UCSD-Quadcopter-Class/quad-hardware-douloureux/quadcopter.brd

## EAGLE design quadcopter.brd (2017-05-18)

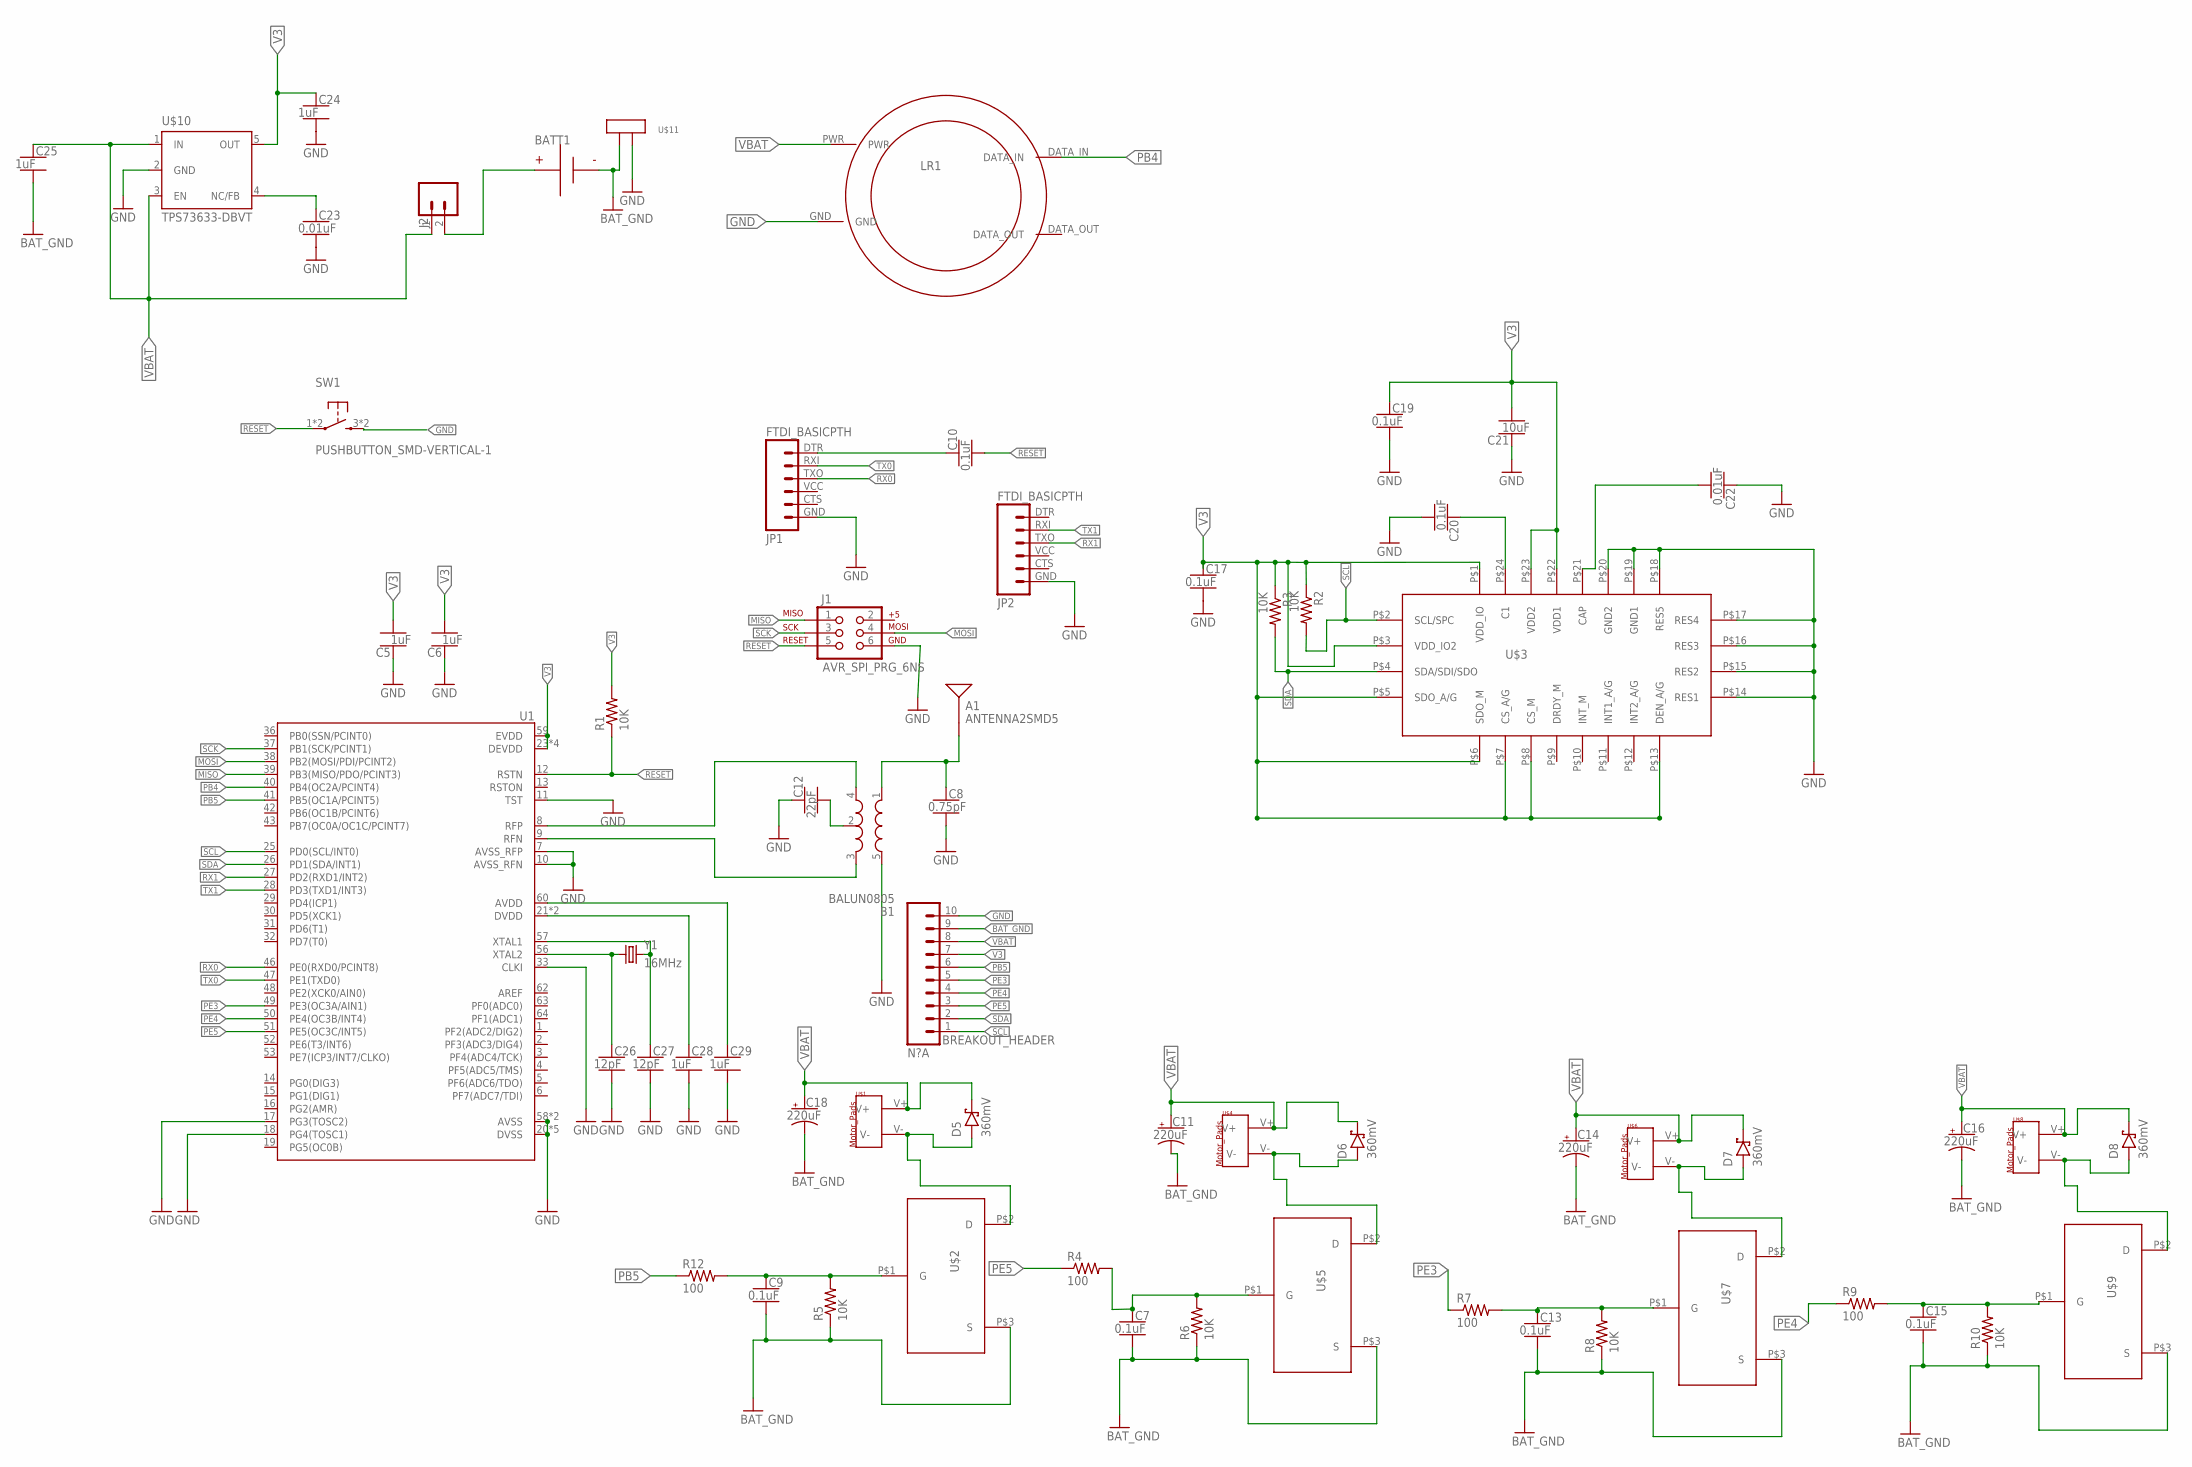
[picture p1: schematic quadcopter.sch]

Parts:
A1: ANTENNA2SMD5; ANTENNA-CHIP5
B1: BALUN0805; BALUN
BATT1: BATTERY-HUBSAN-W/HOLDER; BATTERY-W/HOLDER-380MAH-HUBSAN
BREAKOUT_HEADER: N?A; HDRV10W63P254_10X1_2540X254H838_HS
C5, C6, C24, C25, C28, C29: 1uF; CAPC2012X140_HS
C7, C9, C13, C15: 0.1uF; CERAMIC_CAP_0805
C8: 0.75pF; CAPC2012X140_HS
C10, C17, C19, C20: 0.1uF; CAPC2012X140_HS
C11, C14, C16, C18: 220uF; CAPMP7343X310_HS
C12: 22pF; CAPC2012X140_HS
C21: 10uF; CAPC2012X140_HS
C22, C23: 0.01uF; CAPC2012X140_HS
C26, C27: 12pF; CAPC2012X140_HS
D5, D6, D7, D8: 360mV; SOD3716X135_HS
J1: AVR_SPI_PRG_6NS; 2X3-NS
J2: MALE_HEADER_2POS-2X1-0.1IN; MALE_HEADER_2X1_0.1IN
JP1, JP2: FTDI_BASICPTH; FTDI_BASIC
LR1: LED_RING
R1, R2, R3, R5, R6, R8, R10: 10K; RESC2012X60_HS
R4, R7, R9, R12: 100; RESC2012X60_HS
SW1: PUSHBUTTON_SMD-VERTICAL-1; TE_FSM8JSMA_HS
U1: ATMEGA128RFA1; QFN-64
U$1, U$4, U$6, U$8: MOTOR_PADS
U$2, U$5, U$7, U$9: N-CHANNEL_MOSFET; N-CHANNELMOFSET
U$3: 9-AXIS_IMU
U$10: TPS73633-DBVT; SOT23-DBV
U$11: NET_BRIDGE
Y1: 16MHz; CRYSTAL-SMD-5X3

Connections:
BAT_GND: BATT1.- (N), BREAKOUT_HEADER.9, C7.2, C9.2, C11.2 (-), C13.2, C14.2 (-), C15.2, C16.2 (-), C18.2 (-), C25.2, R5.1, R6.1, R8.1, R10.1, U$2.P$3 (S), U$5.P$3 (S), U$7.P$3 (S), U$9.P$3 (S), U$11.P$1
GND: B1.5 (GND), BREAKOUT_HEADER.10, C5.1, C6.1, C8.2, C12.1, C17.2, C19.2, C20.2, C21.1, C22.1, C23.2, C24.2, C26.2, C27.2, C28.2, C29.2, J1.6, JP1.GND (6), JP2.GND (6), LR1.GND, SW1.3 (2), SW1.4 (2), U1.7 (AVSS_RFP), U1.10 (AVSS_RFN), U1.11 (TST), U1.17 (PG3(TOSC2)), U1.18 (PG4(TOSC1)), U1.20 (DVSS), U1.24 (DVSS), U1.33 (CLKI), U1.35 (DVSS), U1.45 (DVSS), U1.55 (DVSS), U1.58 (AVSS), U1.61 (AVSS), U$3.P$14 (RES1), U$3.P$15 (RES2), U$3.P$16 (RES3), U$3.P$17 (RES4), U$3.P$18 (RES5), U$3.P$19 (GND1), U$3.P$20 (GND2), U$10.2 (GND), U$11.P$2
MISO: J1.1, U1.39 (PB3(MISO/PDO/PCINT3))
MOSI: J1.4, U1.38 (PB2(MOSI/PDI/PCINT2))
unnamed: C9.1, R5.2, R12.2, U$2.P$1 (G)
unnamed: C7.1, R4.2, R6.2, U$5.P$1 (G)
unnamed: A1.FEED, B1.1 (IN), C8.1
unnamed: B1.2 (GND), C12.2
unnamed: C10.1, JP1.DTR (1)
unnamed: D6.A, U$4.V-, U$5.P$2 (D)
unnamed: C13.1, R7.2, R8.2, U$7.P$1 (G)
unnamed: D5.A, U$1.V-, U$2.P$2 (D)
unnamed: D7.A, U$6.V-, U$7.P$2 (D)
unnamed: C15.1, R9.2, R10.2, U$9.P$1 (G)
unnamed: D8.A, U$8.V-, U$9.P$2 (D)
unnamed: C20.1, U$3.P$24 (C1)
unnamed: C22.2, U$3.P$21 (CAP)
unnamed: C26.1, U1.56 (XTAL2), Y1.1
unnamed: BATT1.+, J2.2
unnamed: C23.1, U$10.4 (NC/FB)
unnamed: B1.4 (OUT1), U1.8 (RFP)
unnamed: B1.3 (OUT2), U1.9 (RFN)
unnamed: C29.1, U1.60 (AVDD)
unnamed: C28.1, U1.21 (DVDD), U1.22 (DVDD)
unnamed: C27.1, U1.57 (XTAL1), Y1.3 (2)
PB4: LR1.DATA_IN, U1.40 (PB4(OC2A/PCINT4))
PB5: BREAKOUT_HEADER.6, R12.1, U1.41 (PB5(OC1A/PCINT5))
PE3: BREAKOUT_HEADER.5, R7.1, U1.49 (PE3(OC3A/AIN1))
PE4: BREAKOUT_HEADER.4, R9.1, U1.50 (PE4(OC3B/INT4))
PE5: BREAKOUT_HEADER.3, R4.1, U1.51 (PE5(OC3C/INT5))
RESET: C10.2, J1.5, R1.1, SW1.1, SW1.2 (1), U1.12 (RSTN)
RX0: JP1.TXO (3), U1.46 (PE0(RXD0/PCINT8))
RX1: JP2.TXO (3), U1.27 (PD2(RXD1/INT2))
SCK: J1.3, U1.37 (PB1(SCK/PCINT1))
SCL: BREAKOUT_HEADER.1, R2.2, U1.25 (PD0(SCL/INT0)), U$3.P$2 (SCL/SPC)
SDA: BREAKOUT_HEADER.2, R3.2, U1.26 (PD1(SDA/INT1)), U$3.P$4 (SDA/SDI/SDO)
TX0: JP1.RXI (2), U1.47 (PE1(TXD0))
TX1: JP2.RXI (2), U1.28 (PD3(TXD1/INT3))
V3: BREAKOUT_HEADER.7, C5.2, C6.2, C17.1, C19.1, C21.2, C24.1, R1.2, R2.1, R3.1, U1.23 (DEVDD), U1.34 (DEVDD), U1.44 (DEVDD), U1.54 (DEVDD), U1.59 (EVDD), U$3.P$1 (VDD_IO), U$3.P$3 (VDD_IO2), U$3.P$5 (SDO_A/G), U$3.P$6 (SDO_M), U$3.P$7 (CS_A/G), U$3.P$8 (CS_M), U$3.P$13 (DEN_A/G), U$3.P$22 (VDD1), U$3.P$23 (VDD2), U$10.5 (OUT)
VBAT: BREAKOUT_HEADER.8, C11.1 (+), C14.1 (+), C16.1 (+), C18.1 (+), C25.1, D5.C, D6.C, D7.C, D8.C, J2.1, LR1.PWR, U$1.V+, U$4.V+, U$6.V+, U$8.V+, U$10.1 (IN), U$10.3 (EN)

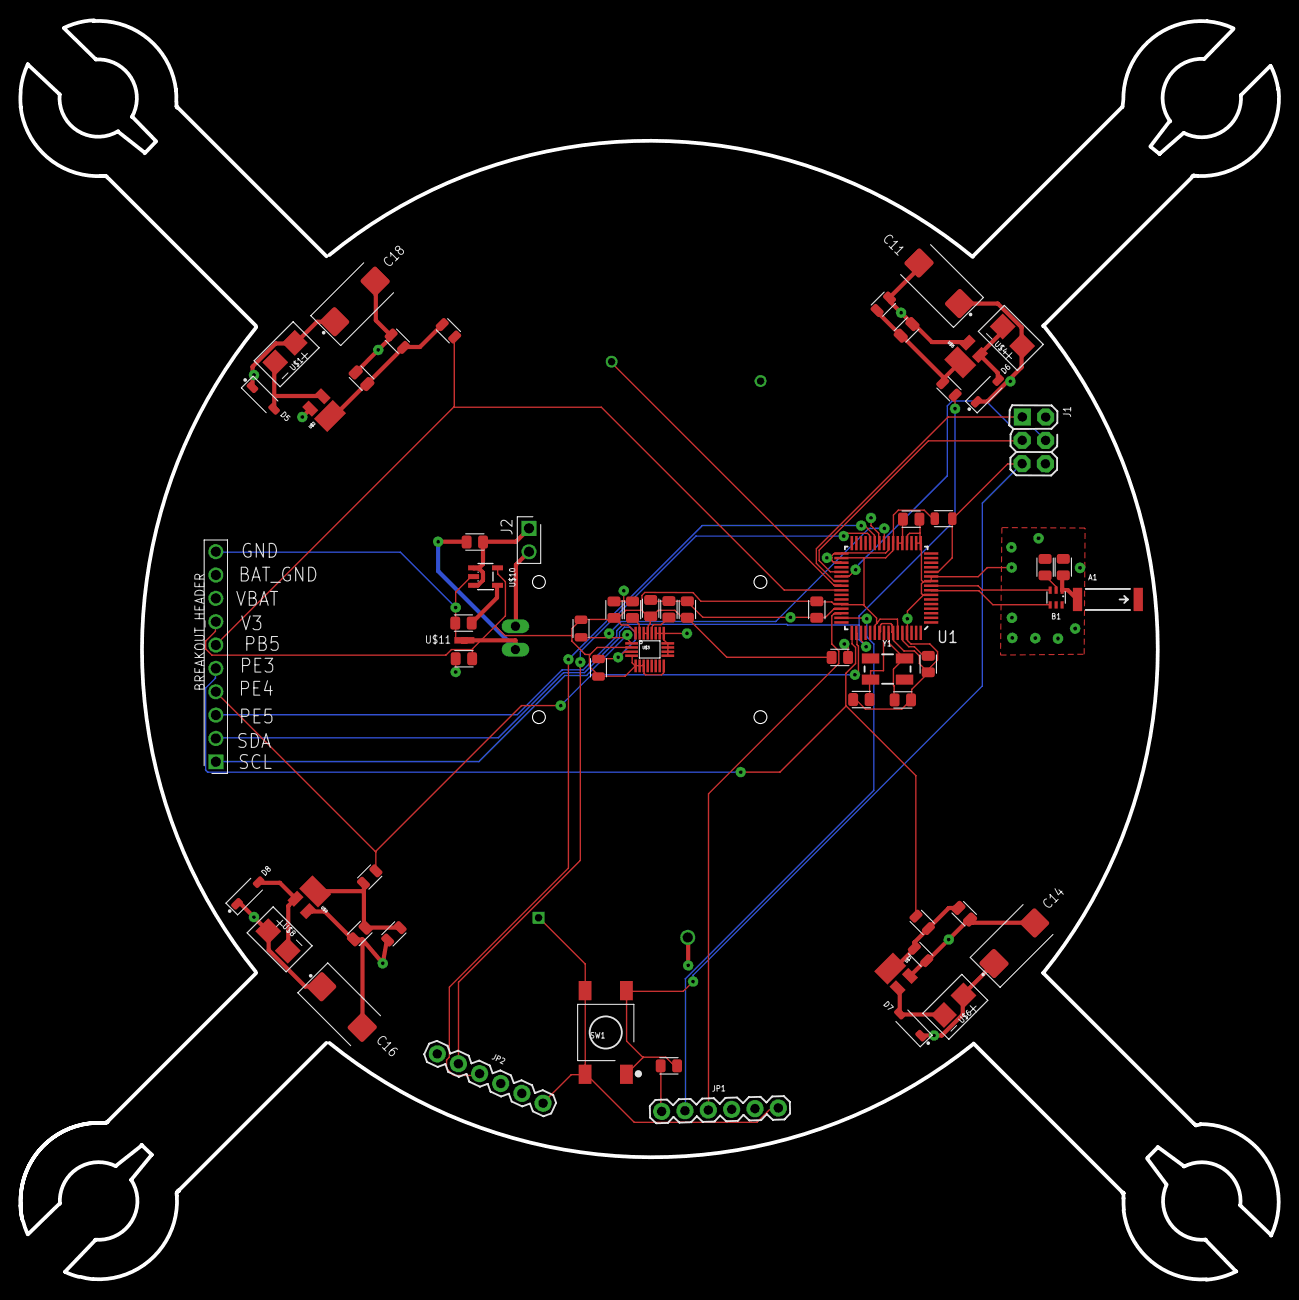
[picture p2: board quadcopter.brd from above]

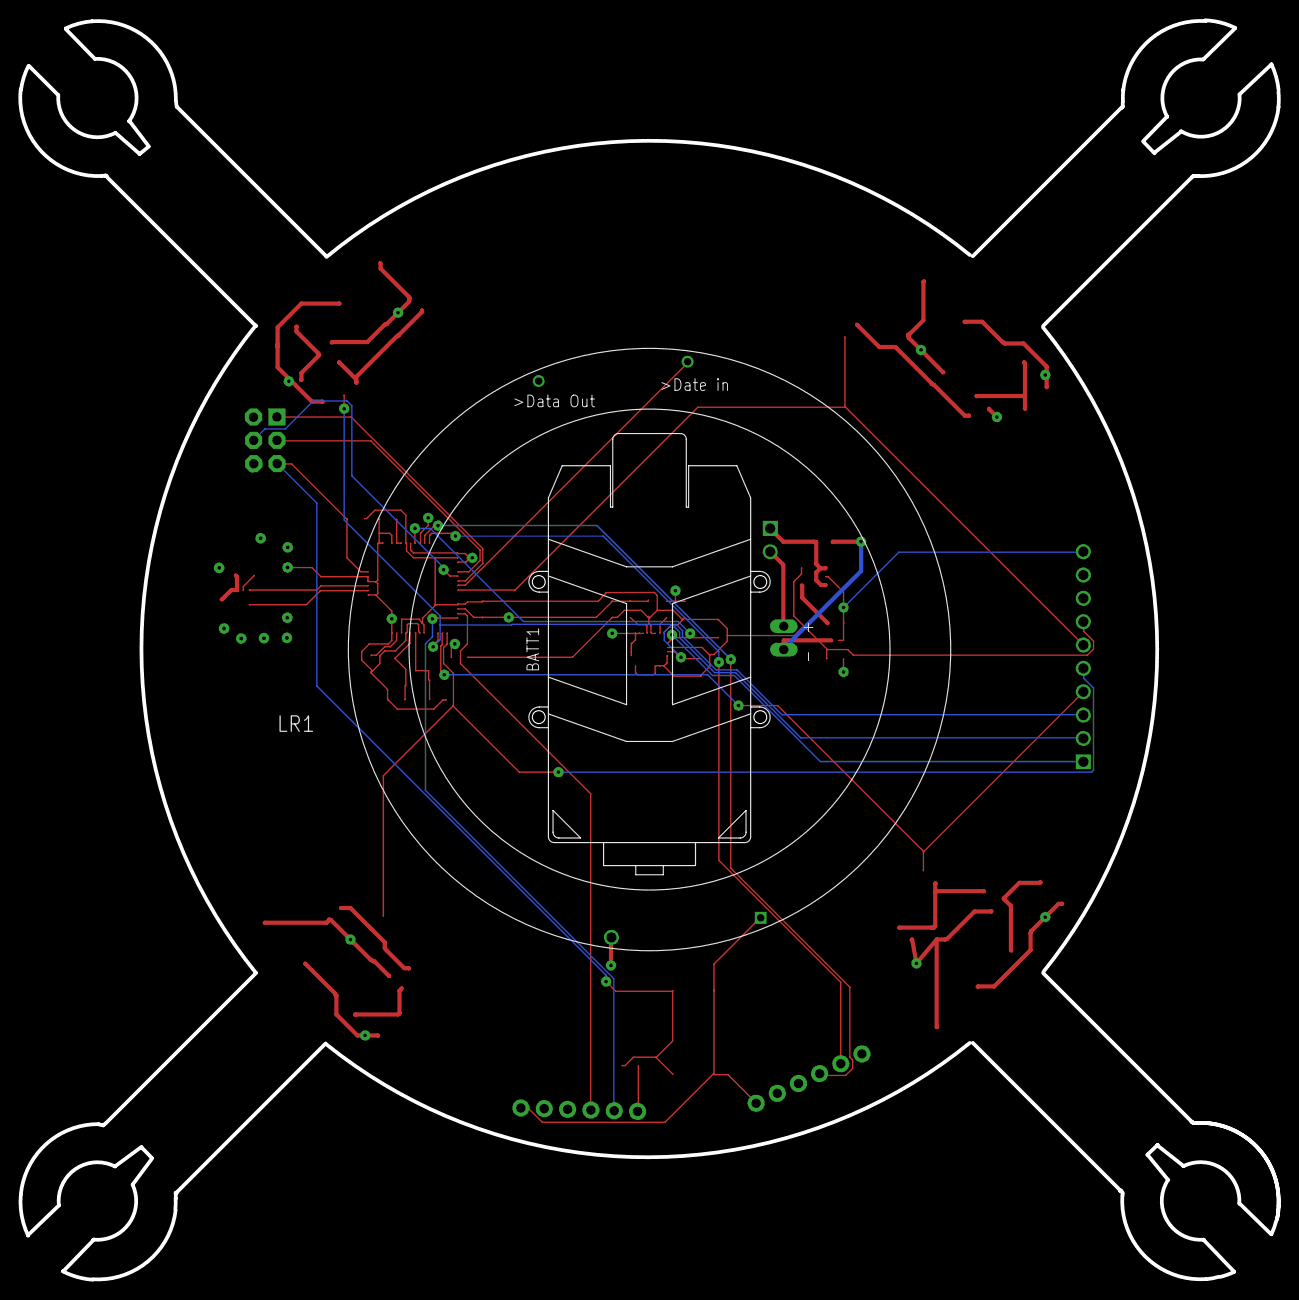
[picture p3: board quadcopter.brd from below]

Board: 4 copper layers, 136.9 x 137.0 mm, 63 parts (2 on the bottom side), 40 nets.
