UCSD-Quadcopter-Class/quad-hardware-douloureux/(commit log)

2017-04-18 Updated Zhe's lbr schematic
2017-04-18 Upload quardparts schematic
    [quadparts.sch]
2017-04-19 Finished Microcontroller, will be working on motors next
    [quadparts.sch]
2017-04-19 Calling it a day
    [quadparts.sch]
2017-04-20 Did I tag? Submitting for Lab 4
    [quadparts.sch]
2017-04-20 change switch to male header
2017-04-25 a lot of updtes
    [quadparts.sch]
2017-04-25 Changes to Schematic
    [quadparts.sch]
2017-04-25 Finished schematic review, tagging next
2017-04-25 Fixed all connections, still need to change LEDs and give values to pieces
    [quadparts.sch]
2017-04-25 Updated libraries and also put in net bridge
    [quadparts.sch]
2017-04-27 instructior review of original schematic
2017-04-27 Current schematic
    [quadparts.sch]
2017-04-27 Updated IMU
    [quadparts.sch]
2017-04-30 Fixed junctions and pull up resistor
    [quadparts.sch]
2017-04-30 updated schematic review
2017-05-01 first draft of board design
    [quadparts.brd, quadparts.sch]
2017-05-02 Finished Professor's review
    [quadparts.sch]
2017-05-02 add new led ring
2017-05-02 Life is so hard
    [quadparts.brd, quadparts.sch]
2017-05-02 I did push
    [quadparts.brd, quadparts.sch]
2017-05-02 Not sure what I changed here
    [quadparts.sch]
2017-05-02 ... Zhe help I'm not sure how to fix the board
    [quadparts.sch]
2017-05-02 fix everything
    [quadparts.brd, quadparts.sch]
2017-05-02 minor fix the board
    [quadparts.brd, quadparts.sch]
2017-05-04 Board design reviews
2017-05-07 Renamed schematics
    [quadcopter.brd, quadcopter.sch]
2017-05-07 Moved parts around on board, trying to connect air wires
    [quadcopter.brd]
2017-05-07 Trying to fix air wires
    [quadcopter.brd]
2017-05-07 Curently updating
    [quadcopter.brd, quadcopter.sch]
2017-05-07 Yay 5 air wires and less erorrs
    [quadcopter.brd, quadcopter.sch]
2017-05-08 Almsot done with board
    [quadcopter.brd, quadcopter.sch]
2017-05-08 Currently fixing width issues
    [quadcopter.brd, quadcopter.sch]
2017-05-09 Finished All Air-wires, the remaining airwires are already connected yet wishes to connect to others of the same connection. Need to ask
    [quadcopter.brd, quadcopter.sch]
2017-05-09 No more errorsgit add quadcopter.brd
    [quadcopter.brd]
2017-05-11 Fixed some library issues and also updates for new DRC file
    [quadparts1.brd]
2017-05-14 more schematic comments from swanson
2017-05-15 Finished Board and Passed FREEDFM
    [quadcopter.sch]
2017-05-16 deleted files from git
    [quadparts1.brd]
2017-05-16 Board comments from swanson
2017-05-17 Changes from first board review
    [quadcopter.brd, quadcopter.sch]
2017-05-18 fix mosfet
